Cadburies/MarineBoard/Documentation/Safe GPIO Pins.png

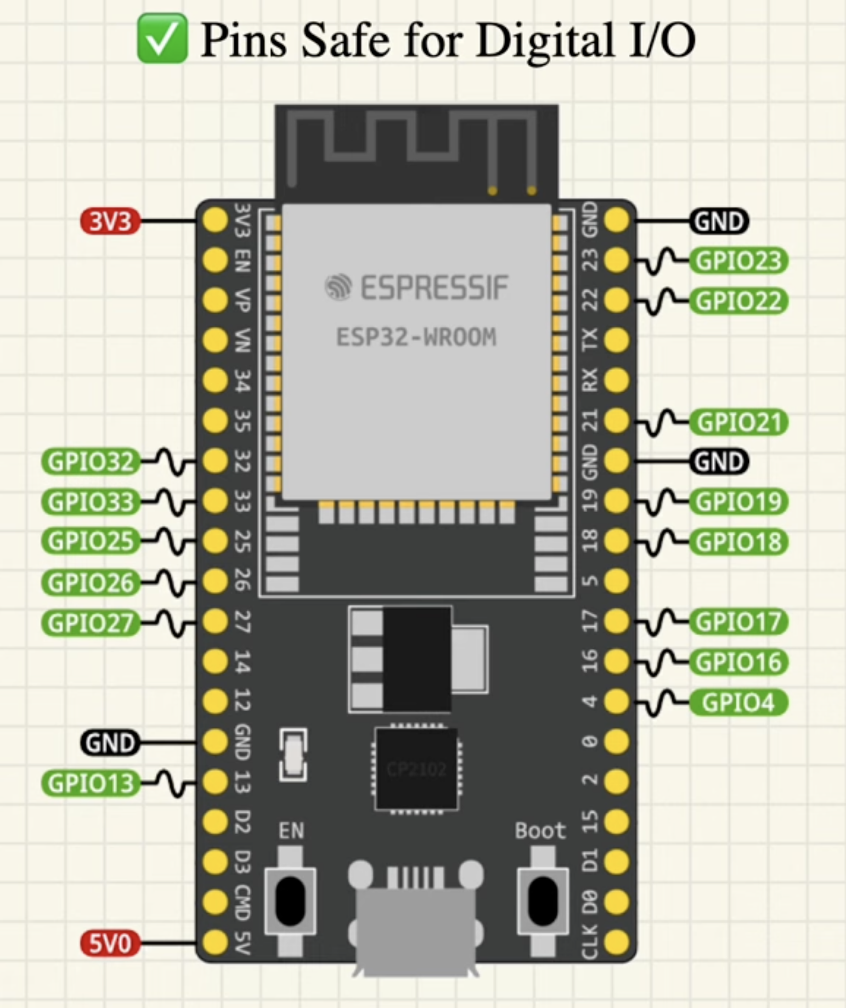
Documentation/Safe GPIO Pins.png
