Cadburies/MarineBoard/README.md

This project moved into SisuAssistant where the full spec, schematics, and pcb layout are:  https://github.com/Cadburies/SisuAssistant/tree/main/MarineBoard
