Cadburies/MarineBoard/Flyer.md

SailingSisu Marine Control Board
Smart, Rugged, and Reliable – Empower Your Boat's Systems
Revolutionize Your Marine Setup with One Compact Board!
Built for sailors and boat enthusiasts, the SailingSisu Marine Control Board is your all-in-one solution for monitoring and controlling essential systems on board. Powered by the advanced ESP32-S3 microcontroller, this board handles alternators, tanks, temperatures, and more – all in a marine-grade design that's tough against salt, vibration, and EMI. Whether you're optimizing power, monitoring levels, or automating relays, it's plug-and-play ready for Home Assistant, SignalK, or MQTT integration.
Key Features & Benefits:

Alternator Mastery: Dual PWM drivers for precise field control (up to 20A), with real-time current/voltage monitoring via INA226. Prevent overcharge and extend battery life – perfect for LiFePO4 setups!
Tank Level Monitoring: Supports two pressure sensors (0-1m range) for accurate fuel/water tank readings. No more guesswork – get alerts via WiFi/Bluetooth.
Thermostat & Relay Control: Two DS18B20 temp sensors and relays (10A/240V) for generic automation, like fridge compressors or engine cooling. Set it and forget it!
Battery & RPM Insights: Continuous 12V battery monitoring plus RPM input for engine health checks. Stay ahead of issues with CAN bus support for Victron/Raymarine/Yanmar.
Marine-Ready Design: 9-32V input, EMI filtering, opto-isolation, and screw terminals for easy wiring. Compact size (ESP32-S3-WROOM-2 module) with on-board antenna – fits in tight engine rooms.
Smart Integration: WiFi/Bluetooth for remote access, error buzzer/LED for diagnostics, and deep sleep mode for low power (under 500mA). Seamless with Home Assistant or SignalK.

Why Choose SailingSisu?

Built for the Sea: IP-rated protection, ferrite beads, and TVS diodes handle harsh conditions – from Caribbean anchorages to open ocean.
Easy Setup: Screw terminals with clear labels (e.g., BPOS, PWM1, TMP1). Flash with ESPHome YAML for custom automations.
Affordable & Expandable: Starting at $XX – includes breakout for unused GPIOs. One board per engine room, scalable for multi-setup boats.
Community-Driven: From @SailingSisu – tested on real voyages. Join our X community for tips and updates!

Real-World Applications:

Monitor alternator output and battery levels on your sailboat.
Automate bilge pumps or fridges based on temp/levels.
Integrate with NMEA/SignalK for full dashboard views.

Get Yours Today!
Order now at sailingsisu.com/board or DM @SailingSisu on X.
Limited stock – Free shipping to Florida!
Questions? Scan QR for docs or contact frik@sailingsisu.com

Tech Specs at a Glance:

ESP32-S3 Dual-Core (240MHz) with 32MB Flash/16MB PSRAM
Operating: -40°C to 65°C, 3.0-3.6V
Certifications: RoHS/REACH

Designed in Caribbean – For Sailors Worldwide
