Cadburies/MarineBoard/Documentation/12V Battery Monitor.png

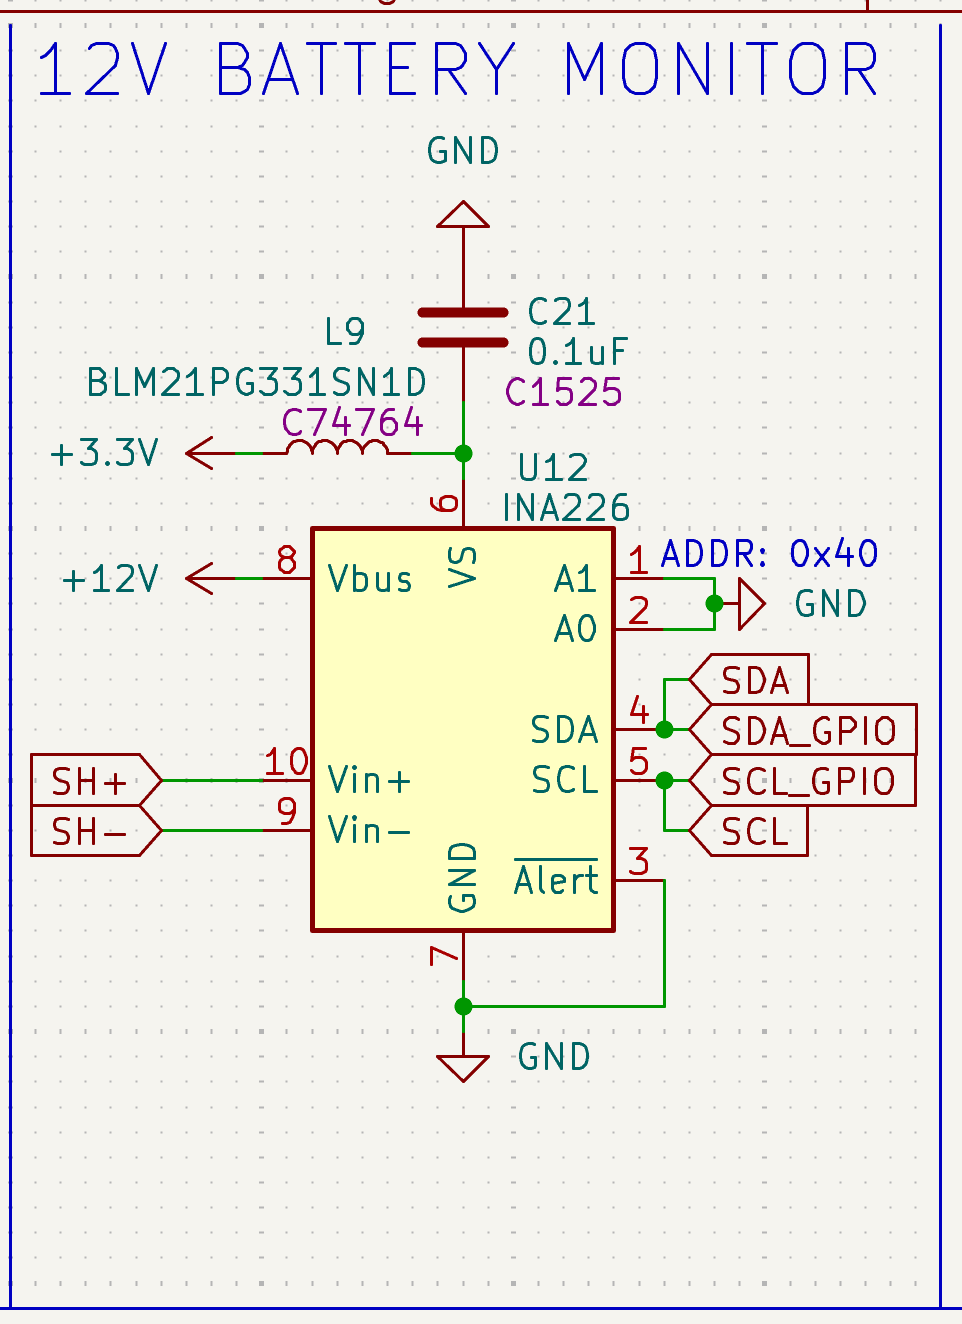
Documentation/12V Battery Monitor.png
