Cadburies/MarineBoard/Documentation/Battery Charger.png

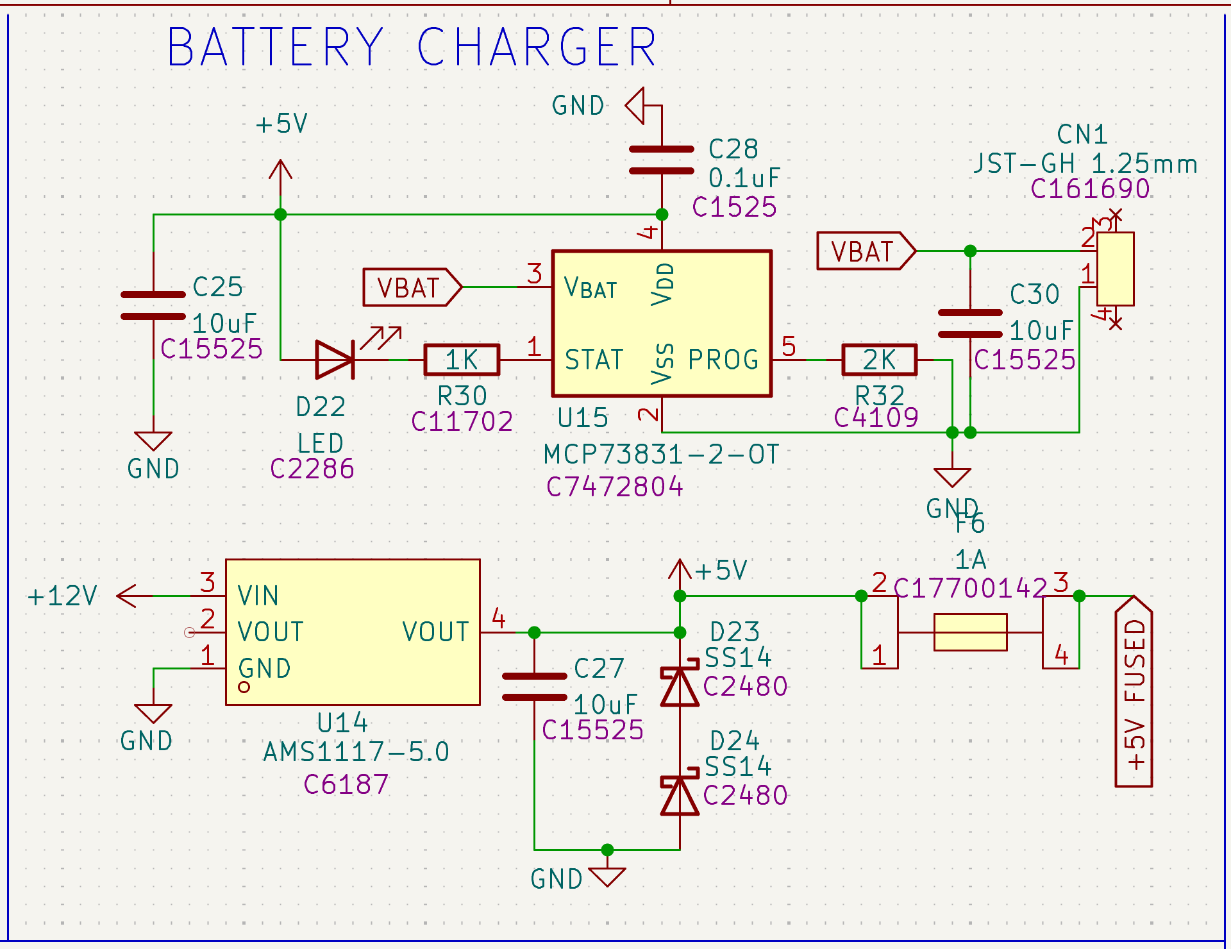
Documentation/Battery Charger.png
