Cadburies/MarineBoard/Documentation/CAN Interface.png

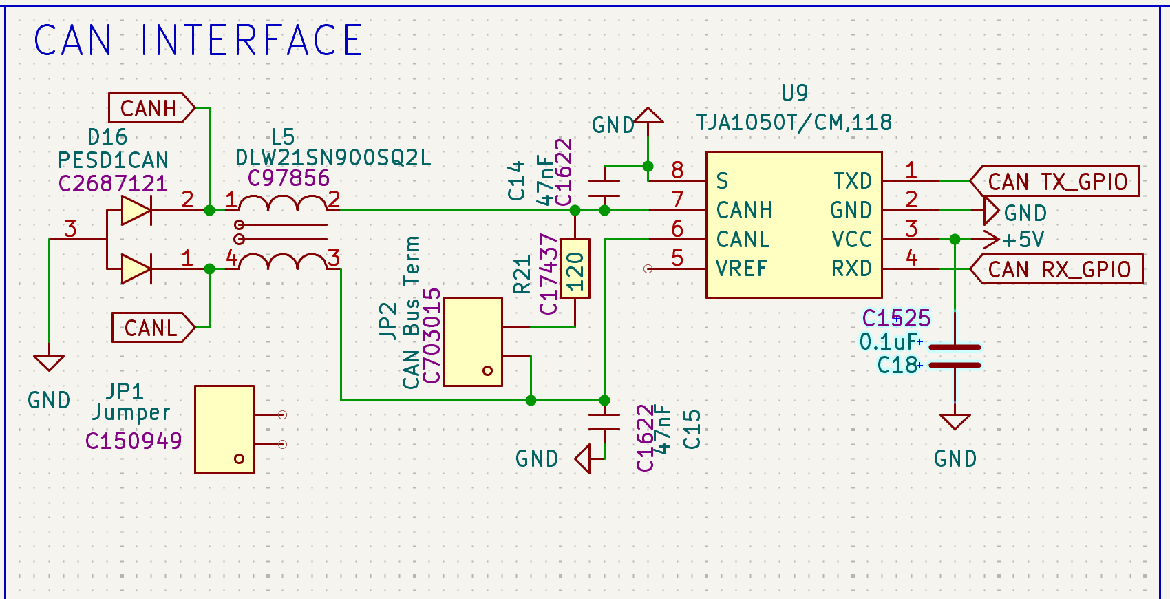
Documentation/CAN Interface.png
