Cadburies/MarineBoard/Documentation/Levels Monitor.png

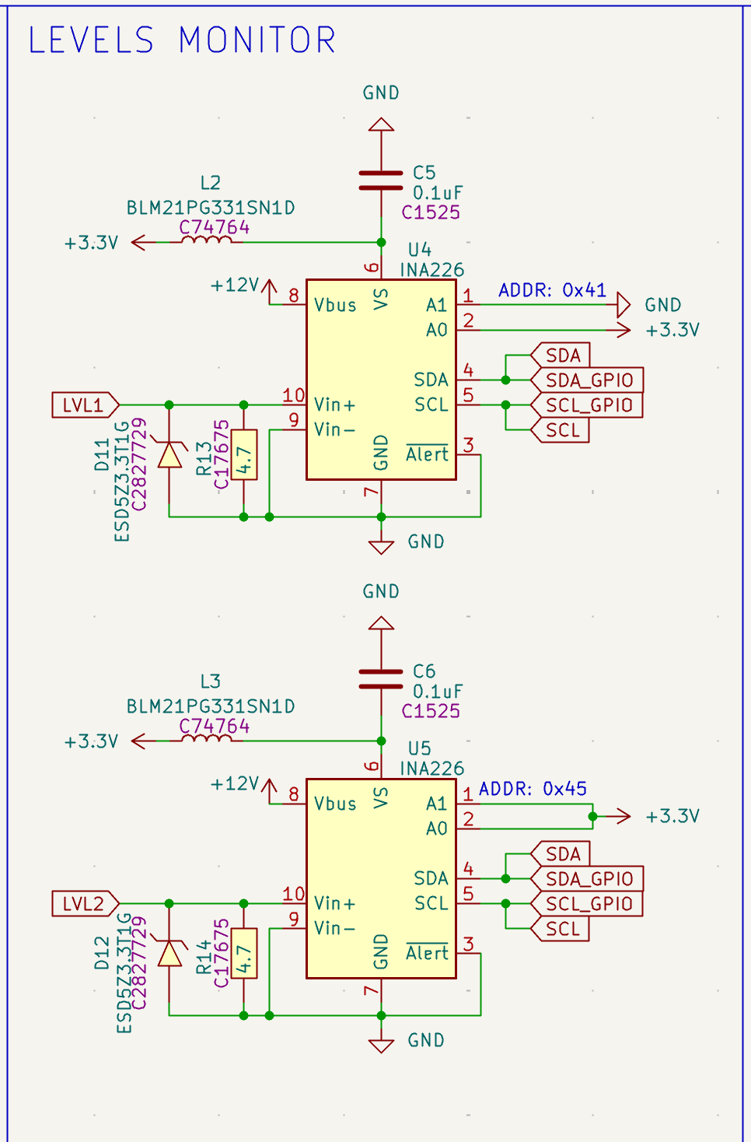
Documentation/Levels Monitor.png
