Cadburies/MarineBoard/Documentation/Power_Filtering.png

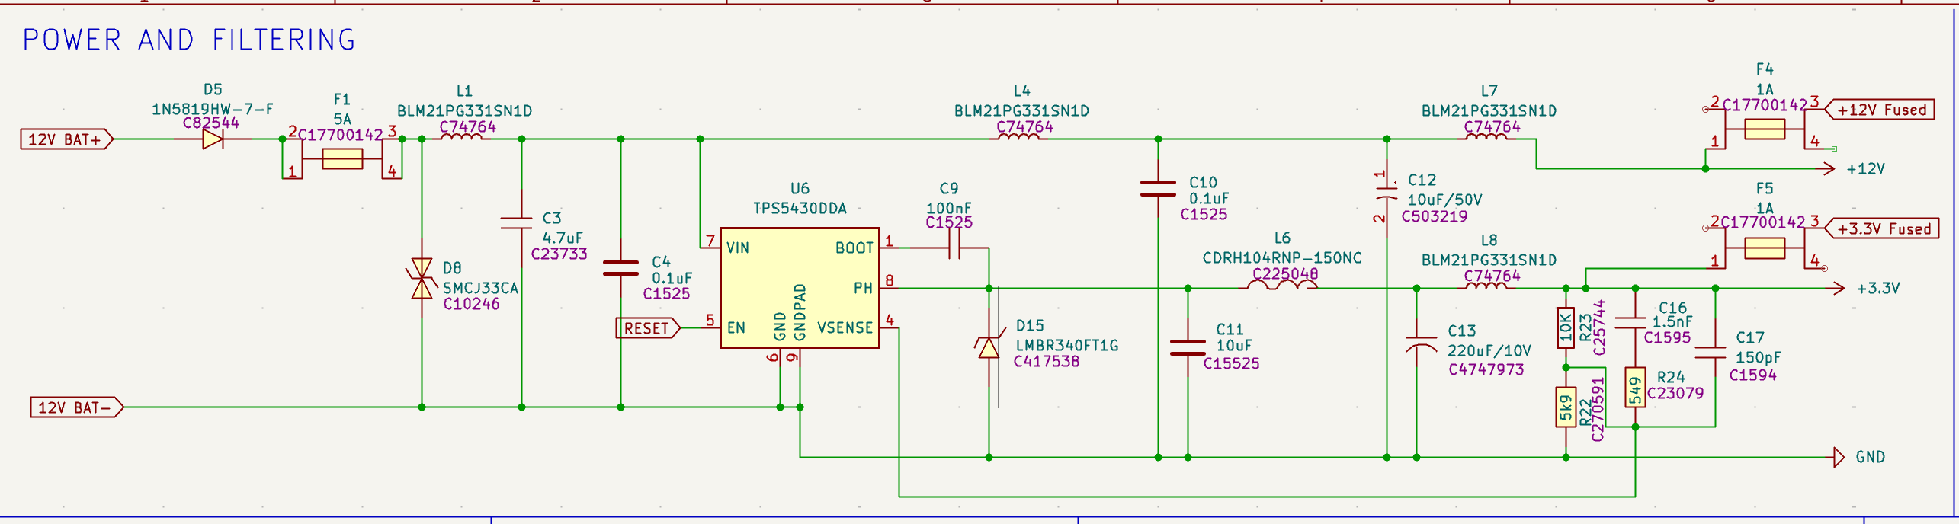
Documentation/Power_Filtering.png
