Cadburies/MarineBoard/Documentation/PWM Drivers.png

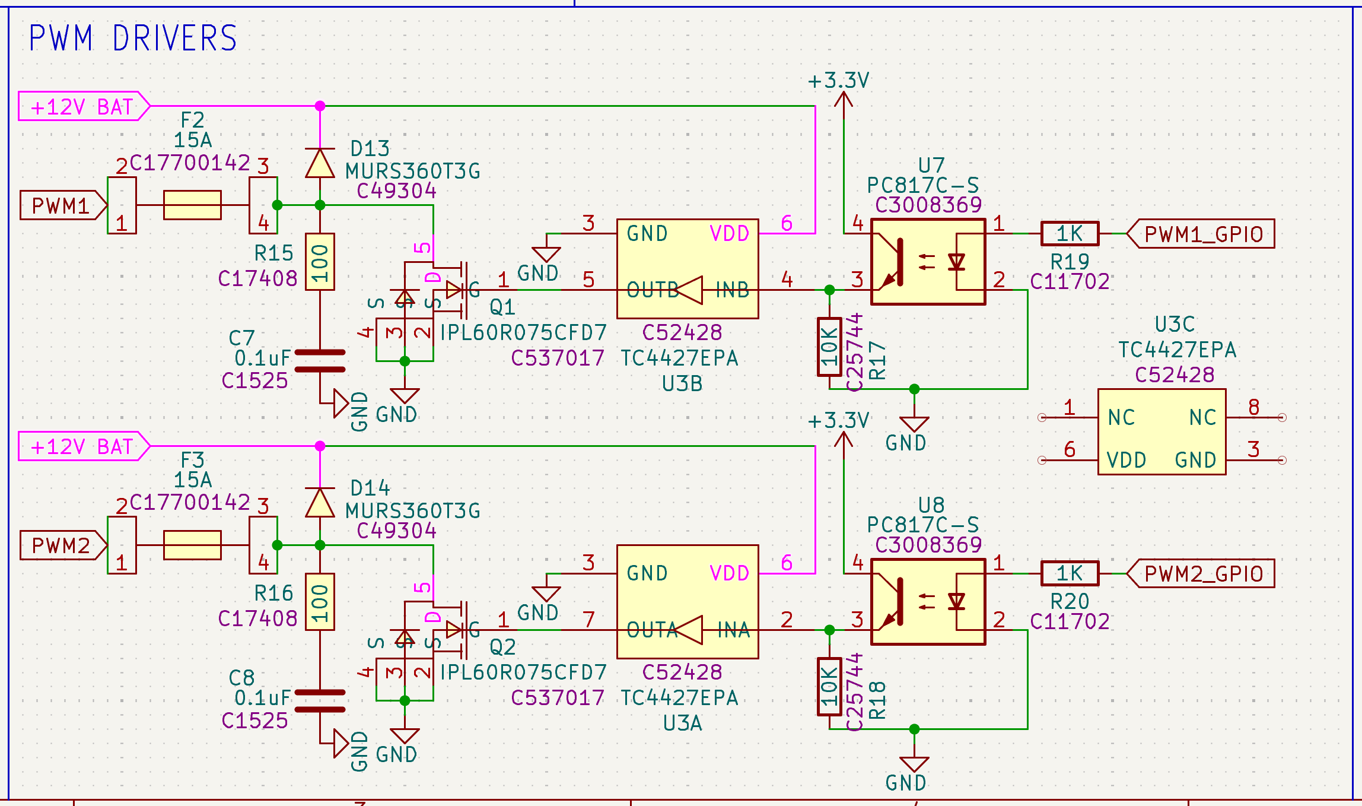
Documentation/PWM Drivers.png
