Cadburies/MarineBoard/MarineBoard.kicad_pcb

## KiCad design MarineBoard.kicad_pcb (2026-03-23)

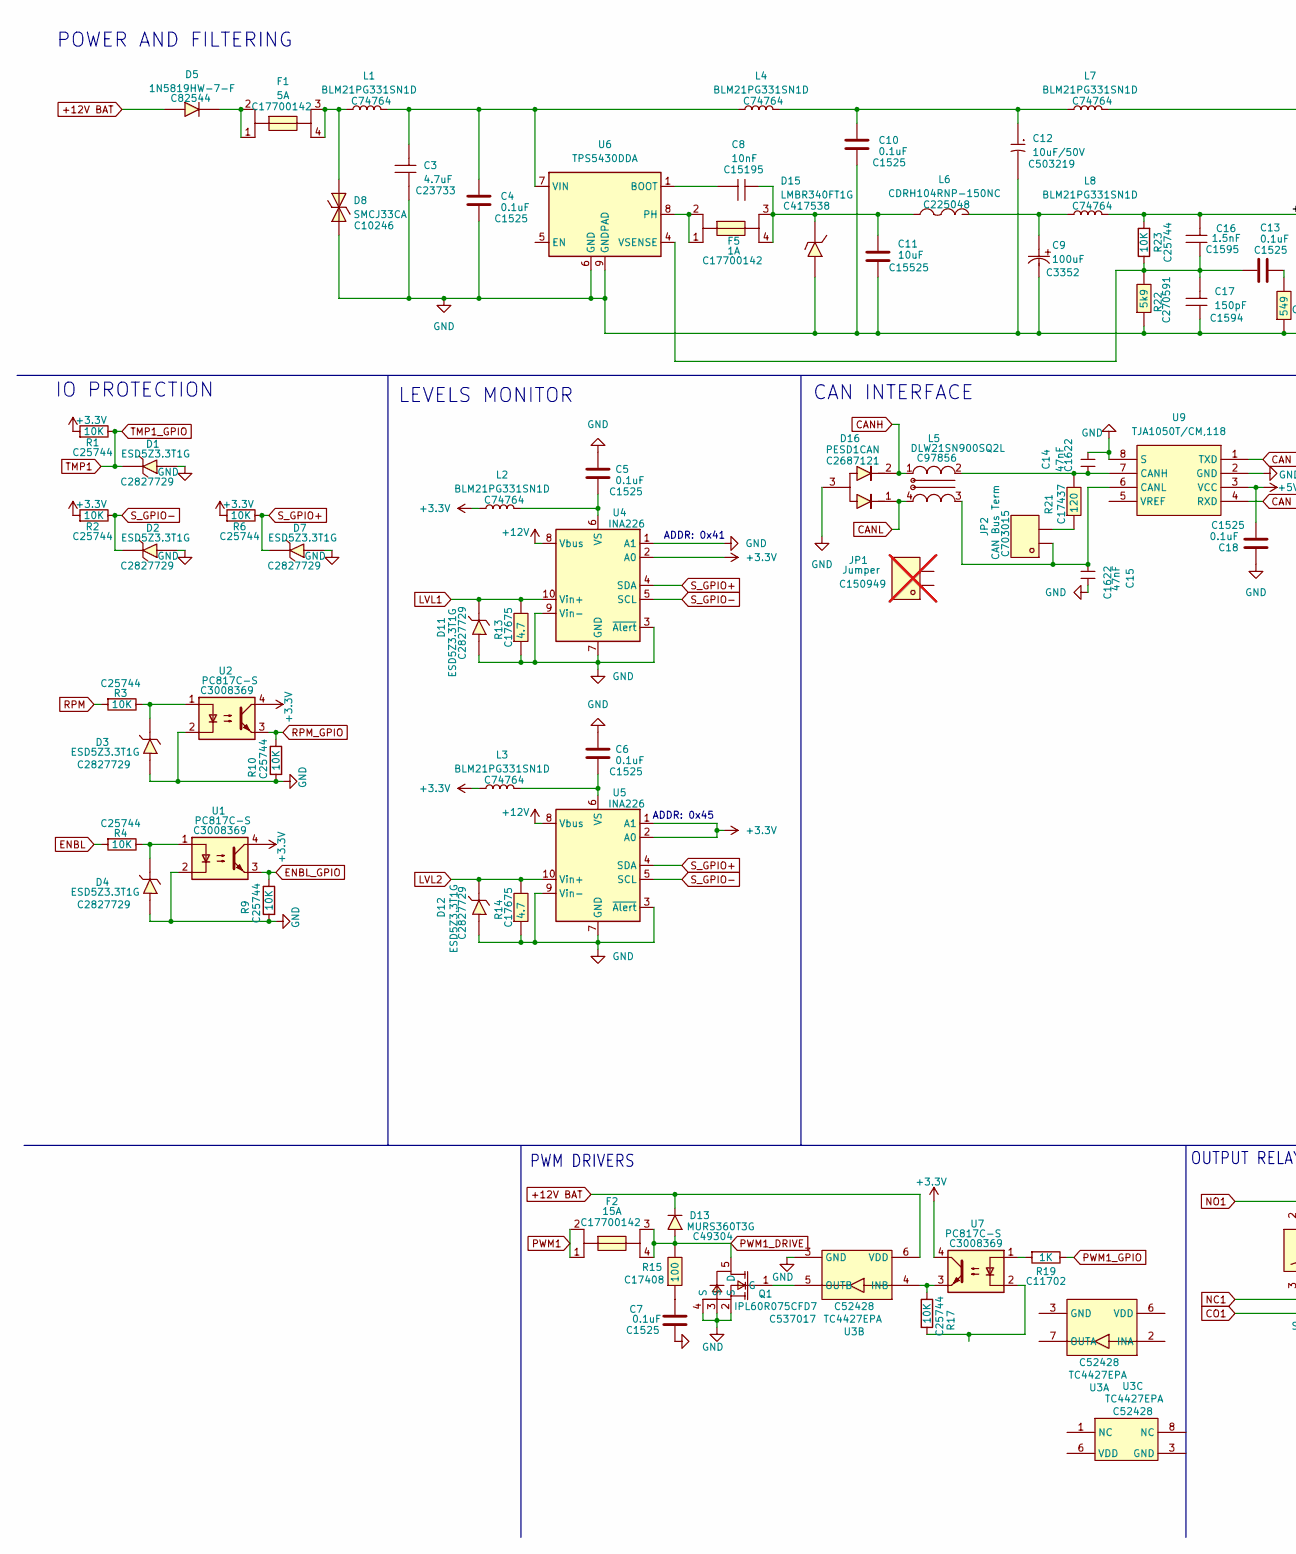
[picture p8: schematic MarineBoard.kicad_sch, part in row 1, column 1]

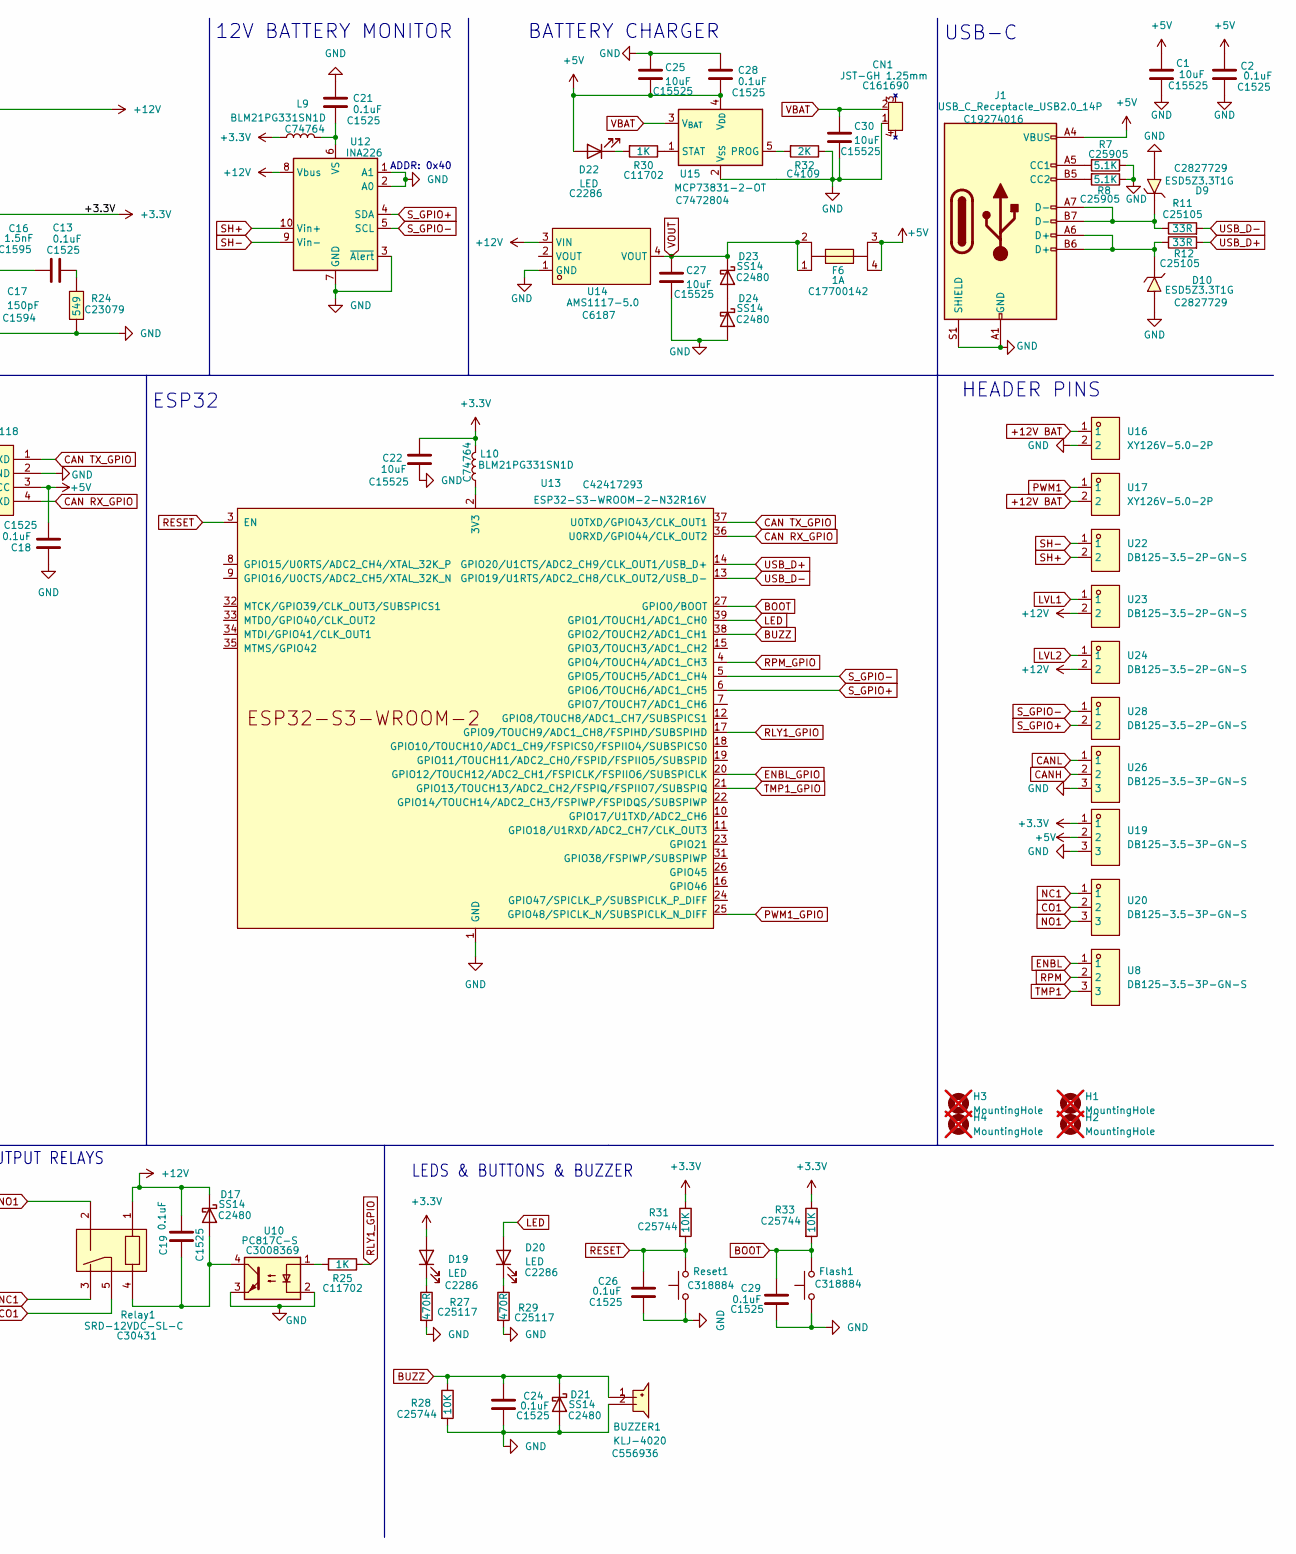
[picture p9: schematic MarineBoard.kicad_sch, part in row 1, column 2]

Parts:
BUZZER1: KLJ-4020; BUZ-SMD_L4.0-W4.0-P3.50-L; LCSC Part C556936
C1, C11, C22, C25, C27, C30: 10uF; C_0402_1005Metric; MNF PART NUMBER C15525; LCSC C15525
C2, C4, C5, C6, C7, C10, C13, C18, C19, C21, C24, C26, C28, C29: 0.1uF; C_0402_1005Metric; MNF PART NUMBER C1525; LCSC C1525
C3: 4.7uF; C0402; LCSC Part C23733
C8: 10nF; C0402; LCSC Part C15195
C9: 100uF; CAP-SMD_BD8.0-L8.3-W8.3-FD; LCSC Part C3352
C12: 10uF/50V; CAP-TH_BD5.0-P2.00-D0.8-FD; LCSC Part C503219
C14, C15: 47nF; C0603; LCSC Part C1622
C16: 1.5nF; C0603; LCSC Part C1595
C17: 150pF; C0603; LCSC Part C1594
CN1: JST-GH 1.25mm; CONN-SMD_2P-P1.25_BM02B-GHS-TBT-LF-SN; LCSC Part C161690
D1, D2, D3, D4, D7, D9, D10, D11, D12: ESD5Z3.3T1G; SOD-523_L1.2-W0.8-LS1.6-FD; LCSC Part C2827729
D5: 1N5819HW-7-F; SOD-123_L2.7-W1.6-LS3.7-RD; LCSC Part C82544
D8: SMCJ33CA; SMC_L6.9-W5.9-LS7.9-BI; LCSC Part C10246
D13: MURS360T3G; SMC_L7.1-W6.2-LS8.1-R-RD; LCSC Part C49304
D15: LMBR340FT1G; SOD-123FL_L2.7-W1.8-LS3.8-RD; LCSC Part C417538
D16: PESD1CAN; SOT-23-3_L2.9-W1.3-P1.90-LS2.4-BL-2; LCSC Part C2687121
D17, D21, D23, D24: SS14; D_SMA; MNF PART NUMBER C2480; LCSC C2480
D19, D20, D22: LED; LED_0603_1608Metric; MNF PART NUMBER C2286; LCSC C2286
F1: 5A; FUSE-SMD_4P-L16.0-W6.7-P9.92; LCSC Part C17700142
F2: 15A; FUSE-SMD_4P-L16.0-W6.7-P9.92; LCSC Part C17700142
F5, F6: 1A; FUSE-SMD_4P-L16.0-W6.7-P9.92; LCSC Part C17700142
Flash1: Flash; SW_Push_1P1T_XKB_TS-1187A; MNF PART NUMBER C318884; LCSC C318884
H1, H2, H3, H4: MountingHole; MountingHole_3.2mm_M3; not fitted
J1: USB_C_Receptacle_USB2.0_14P; USB_C_Receptacle_HCTL_HC-TYPE-C-16P-01A; MNF PART NUMBER C19274016; LCSC C19274016
JP1: Jumper; HDR-TH_2P-P1.27-V-M; LCSC Part C150949; not fitted
JP2: CAN Bus Term; HDR-TH_2P-P1.27-V-M; LCSC Part C703015
L1, L2, L3, L4, L7, L8, L9, L10: BLM21PG331SN1D; L0805; LCSC Part C74764
L5: DLW21SN900SQ2L; FILTER-SMD_4P-L2.0-W1.2-BL_DLW21H; LCSC Part C97856
L6: CDRH104RNP-150NC; IND-SMD_L10.2-W10.0; LCSC Part C225048
Q1: IPL60R075CFD7; VSON-4_L8.1-W8.1-P2.00-BL; LCSC Part C537017
R1, R2, R3, R4, R6, R9, R10, R17, R23, R28, R31, R33: 10K; R_0402_1005Metric; MNF PART NUMBER C25744; LCSC C25744
R7, R8: 5.1K; R_0402_1005Metric; MNF PART NUMBER C25905; LCSC C25905
R11, R12: 33R; R_0402_1005Metric; MNF PART NUMBER C25105; LCSC C25105
R13, R14: 4.7; R0805; LCSC Part C17675
R15: 100; R0805; LCSC Part C17408
R19, R25, R30: 1K; R_0402_1005Metric; MNF PART NUMBER C11702; LCSC C11702
R21: 120; R0805; LCSC Part C17437
R22: 5k9; R0402; LCSC Part C270591
R24: 549; R0603; LCSC Part C23079
R27, R29: 470R; R_0402_1005Metric; MNF PART NUMBER C25117; LCSC C25117
R32: 2K; R_0402_1005Metric; MNF PART NUMBER C4109; LCSC C4109
Relay1: SRD-12VDC-SL-C; RELAY-TH_SRD-XXVDC-XL-C; LCSC Part C30431
Reset1: Reset; SW_Push_1P1T_XKB_TS-1187A; MNF PART NUMBER C318884; LCSC C318884
U1, U2, U7, U10: PC817C-S; SOP-4_L6.5-W4.6-P2.54-LS10.3-TL; LCSC Part C3008369
U3: TC4427EPA; DIP-8_L9.4-W6.4-P2.54-LS9.1-BL; LCSC Part C52428
U4, U5, U12: INA226; VSSOP-10_3x3mm_P0.5mm
U6: TPS5430DDA; TI_SO-PowerPAD-8_ThermalVias
U8, U19, U20, U26: DB125-3.5-3P-GN-S; CONN-TH_3P-P3.50_L7.4-W10.5; LCSC Part C466971
U9: TJA1050T/CM,118; SOIC-8_L5.0-W4.0-P1.27-LS6.0-BL; LCSC Part C6952
U13: ESP32-S3-WROOM-2-N32R16V; ESP32-S3-WROOM-2; MNF PART NUMBER C42417293; LCSC C42417293
U14: AMS1117-5.0; SOT-223_L6.5-W3.5-P2.30-LS7.0-BR; LCSC Part C6187
U15: MCP73831-2-OT; SOT-23-5; MNF PART NUMBER C7472804; LCSC C7472804
U16, U17: XY126V-5.0-2P; CONN-TH_XY126V-5.0-2P; LCSC Part C557646
U22, U23, U24, U28: DB125-3.5-2P-GN-S; CONN-TH_2P-P3.50_L7.4-W7.0; LCSC Part C466970

Connections:
+3.3V: C16.2, C22.1, D19.2 (A), L2.1, L3.1, L8.2, L9.1, L10.2, R1.2, R2.2, R6.2, R23.2, R31.1, R33.1, U1.4, U2.4, U4.2 (A0), U5.1 (A1), U5.2 (A0), U7.4, U19.1
+5V: C1.1, C2.1, C18.2, C25.2, C28.2, D22.2 (A), F6.3, F6.4, J1.A4 (VBUS), J1.A9 (VBUS), J1.B4 (VBUS), J1.B9 (VBUS), U9.3 (VCC), U15.4 (V_{DD}), U19.2
+12V: C19.1, D17.1 (K), L7.2, Relay1.1, U4.8 (Vbus), U5.8 (Vbus), U12.8 (Vbus), U14.3 (VIN), U23.2, U24.2
+12V BAT: D5.2 (A), D13.2 (K), U3.6 (VDD), U16.1, U17.2
BOOT: C29.2, Flash1.2, R33.2, U13.27 (GPIO0/BOOT)
BUZZ: BUZZER1.1 (+), C24.1, D21.1 (K), R28.1, U13.38 (GPIO2/TOUCH2/ADC1_CH1)
CAN RX_GPIO: U9.4 (RXD), U13.36 (U0RXD/GPIO44/CLK_OUT2)
CAN TX_GPIO: U9.1 (TXD), U13.37 (U0TXD/GPIO43/CLK_OUT1)
CANH: D16.2, L5.1, U26.2
CANL: D16.1, L5.4, U26.1
CO1: Relay1.5, U20.2
ENBL: R4.2, U8.1
ENBL_GPIO: R9.1, U1.3, U13.20 (GPIO12/TOUCH12/ADC2_CH1/FSPICLK/FSPIIO6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)
GND: BUZZER1.2 (-), C1.2, C2.2, C3.1, C4.2, C5.1, C6.1, C7.2, C9.2, C10.2, C11.1, C12.2, C14.2, C15.2, C17.1, C18.1, C21.1, C22.2, C24.2, C25.1, C26.1, C27.2, C28.1, C29.1, C30.2, CN1.1, D1.1 (A), D2.1 (A), D3.1 (A), D4.1 (A), D7.1 (A), D8.1 (K), D9.1 (A), D10.1 (A), D11.1 (A), D12.1 (A), D15.2 (A), D16.3, D21.2 (A), D24.2 (A), Flash1.1, J1.A1 (GND), J1.A12 (GND), J1.B1 (GND), J1.B12 (GND), J1.S1 (SHIELD), Q1.2 (S), Q1.3 (S), Q1.4 (S), R7.1, R8.1, R9.2, R10.2, R13.1, R14.1, R22.1, R24.1, R27.2, R28.2, R29.2, R32.1, Reset1.1, U1.2, U2.2, U3.3 (GND), U4.1 (A1), U4.3 (~Alert), U4.7 (GND), U4.9 (Vin-), U5.3 (~Alert), U5.7 (GND), U5.9 (Vin-), U6.6 (GND), U6.9 (GNDPAD), U9.2 (GND), U9.8 (S), U10.2, U10.3, U12.1 (A1), U12.2 (A0), U12.3 (~Alert), U12.7 (GND), U13.1 (GND), U13.40 (GND), U13.41 (GND), U14.1 (GND), U15.2 (V_{SS}), U16.2, U19.3, U26.3
LED: D20.2 (A), U13.39 (GPIO1/TOUCH1/ADC1_CH0)
LVL1: D11.2 (K), R13.2, U4.10 (Vin+), U23.1
LVL2: D12.2 (K), R14.2, U5.10 (Vin+), U24.1
NC1: Relay1.3, U20.1
NO1: Relay1.2, U20.3
unnamed: C7.1, R15.1
unnamed: C9.1, L6.2, L8.1
unnamed: C10.1, C12.1, L4.2, L7.1
unnamed: C13.2, R24.2
unnamed: D3.2 (K), R3.1, U2.1
unnamed: D4.2 (K), R4.1, U1.1
unnamed: D5.1 (K), F1.1, F1.2
unnamed: D8.2 (A), F1.3, F1.4, L1.1
unnamed: D9.2 (K), J1.A7 (D-), J1.B7 (D-), R11.1
unnamed: D10.2 (K), J1.A6 (D+), J1.B6 (D+), R12.1
unnamed: C8.1, C11.2, D15.1 (C), F5.3, F5.4, L6.1
unnamed: C19.2, D17.2 (A), Relay1.4, U10.4
unnamed: D19.1 (K), R27.1
unnamed: D20.1 (K), R29.1
unnamed: D22.1 (K), R30.2
unnamed: D23.2 (A), D24.1 (K)
unnamed: J1.A5 (CC1), R7.2
unnamed: J1.B5 (CC2), R8.2
unnamed: JP2.2, R21.1
unnamed: Q1.1 (G), U3.5 (OUTB)
unnamed: R17.2, U7.2
unnamed: R19.2, U7.1
unnamed: R25.2, U10.1
unnamed: R17.1, U3.4 (INB), U7.3
unnamed: C5.2, L2.2, U4.6 (VS)
unnamed: C6.2, L3.2, U5.6 (VS)
unnamed: C8.2, U6.1 (BOOT)
unnamed: F5.1, F5.2, U6.8 (PH)
unnamed: C3.2, C4.1, L1.2, L4.1, U6.7 (VIN)
unnamed: C13.1, C16.1, C17.2, R22.2, R23.1, U6.4 (VSENSE)
unnamed: C14.1, L5.2, R21.2, U9.7 (CANH)
unnamed: C15.1, JP2.1, L5.3, U9.6 (CANL)
unnamed: C21.2, L9.2, U12.6 (VS)
unnamed: L10.1, U13.2 (3V3)
unnamed: R32.2, U15.5 (PROG)
unnamed: R30.1, U15.1 (STAT)
PWM1: F2.1, F2.2, U17.1
PWM1_DRIVE: D13.1 (A), F2.3, F2.4, Q1.5 (D), R15.2
PWM1_GPIO: R19.1, U13.25 (GPIO48/SPICLK_N/SUBSPICLK_N_DIFF)
RESET: C26.2, R31.2, Reset1.2, U13.3 (EN)
RLY1_GPIO: R25.1, U13.17 (GPIO9/TOUCH9/ADC1_CH8/FSPIHD/SUBSPIHD)
RPM: R3.2, U8.2
RPM_GPIO: R10.1, U2.3, U13.4 (GPIO4/TOUCH4/ADC1_CH3)
SH+: U12.10 (Vin+), U22.2
SH-: U12.9 (Vin-), U22.1
S_GPIO+: D7.2 (K), R6.1, U4.4 (SDA), U5.4 (SDA), U12.4 (SDA), U13.6 (GPIO6/TOUCH6/ADC1_CH5), U28.2
S_GPIO-: D2.2 (K), R2.1, U4.5 (SCL), U5.5 (SCL), U12.5 (SCL), U13.5 (GPIO5/TOUCH5/ADC1_CH4), U28.1
TMP1: D1.2 (K), R1.1, U8.3, U13.21 (GPIO13/TOUCH13/ADC2_CH2/FSPIQ/FSPIIO7/S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)
USB_D+: R12.2, U13.14 (GPIO20/U1CTS/ADC2_CH9/CLK_OUT1/USB_D+)
USB_D-: R11.2, U13.13 (GPIO19/U1RTS/ADC2_CH8/CLK_OUT2/USB_D-)
VBAT: C30.1, CN1.2, U15.3 (V_{BAT})
VOUT: C27.1, D23.1 (K), F6.1, F6.2, U14.4 (VOUT)

Notes on the sheet:
BATTERY CHARGER
IO PROTECTION
LEDS & BUTTONS & BUZZER
ESP32
HEADER PINS
OUTPUT RELAYS
ADDR: 0x45
ADDR: 0x40
LEVELS MONITOR
CAN INTERFACE
PWM DRIVERS
ADDR: 0x41
POWER AND FILTERING
12V BATTERY MONITOR
USB-C

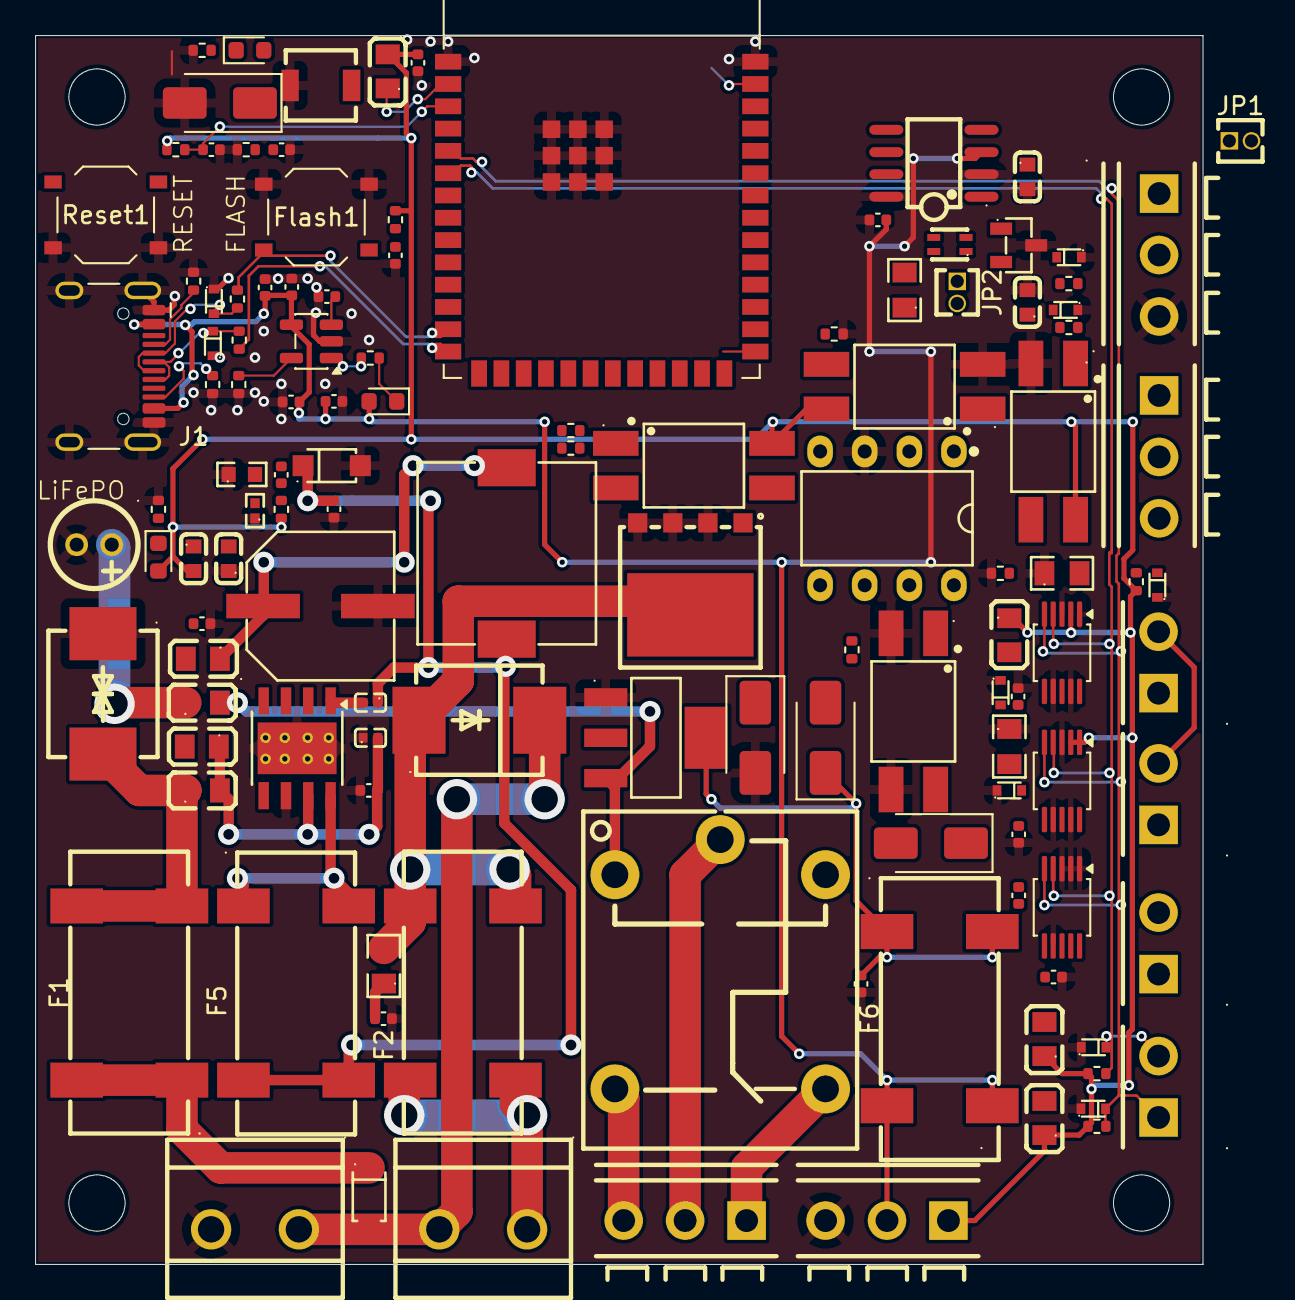
[picture p10: board MarineBoard.kicad_pcb from above]

Board: 2 copper layers, 66.5 x 70.0 mm, 127 parts (1 on the bottom side), 71 nets.
